JosephPalacios-so/CANSAT_ARLISS/ARLISS_STM32_2026.kicad_pcb

## KiCad design ARLISS_STM32_2026.kicad_pcb (2026-08-25)

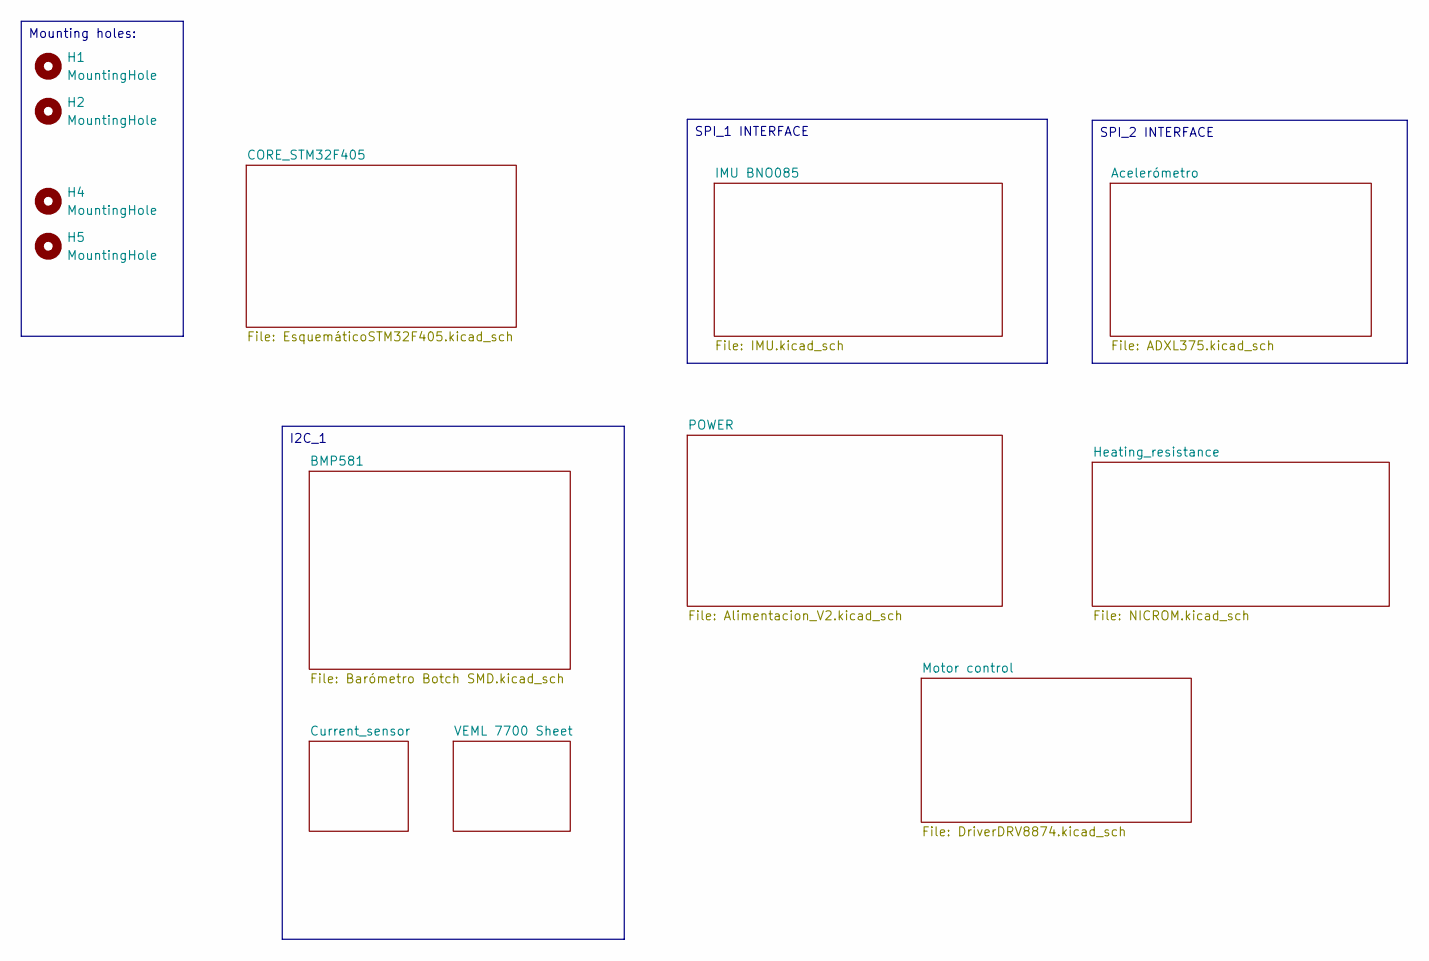
[picture p1: schematic ARLISS_STM32_2026.kicad_sch, ARLISS STM32 BOARD]

Parts:
H1, H2, H4, H5: MountingHole; MountingHole_3.2mm_M3_ISO14580_Pad

Notes on the sheet:
SPI_1 INTERFACE
Mounting holes:
SPI_2 INTERFACE
I2C_1

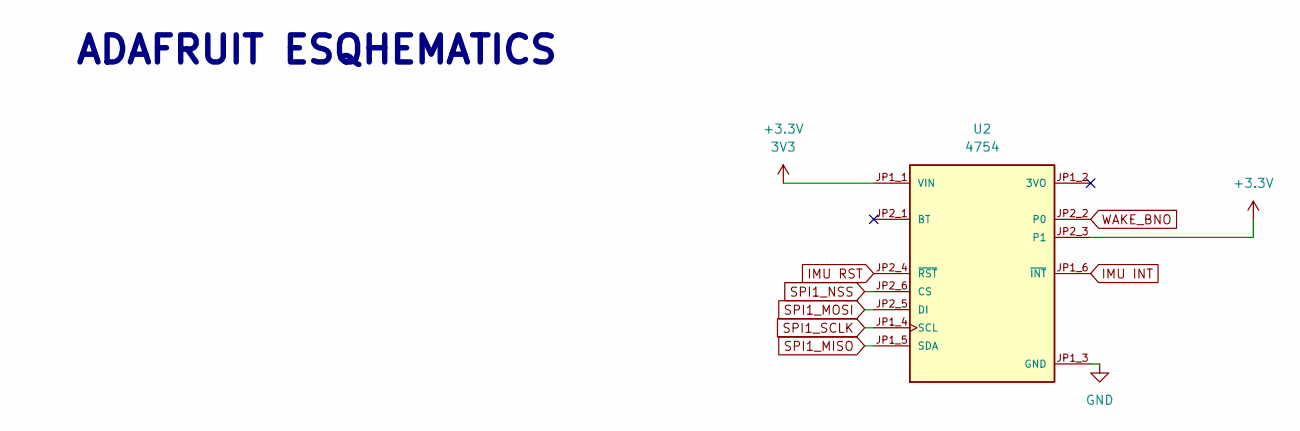
[picture p2: schematic IMU.kicad_sch]

Parts:
U2: 4754; MODULE_4754; PARTREV 2021-03-16

Connections:
+3.3V: U2.JP1_1 (VIN), U2.JP2_3 (P1); also elsewhere on the board
GND: U2.JP1_3 (GND); also elsewhere on the board
IMU INT: U2.JP1_6 (~INT); also elsewhere on the board
IMU RST: U2.JP2_4 (~RST); also elsewhere on the board
SPI1_MISO: U2.JP1_5 (SDA); also elsewhere on the board
SPI1_MOSI: U2.JP2_5 (DI); also elsewhere on the board
SPI1_NSS: U2.JP2_6 (CS); also elsewhere on the board
SPI1_SCLK: U2.JP1_4 (SCL); also elsewhere on the board
WAKE_BNO: U2.JP2_2 (P0); also elsewhere on the board

Notes on the sheet:
ADAFRUIT ESQHEMATICS

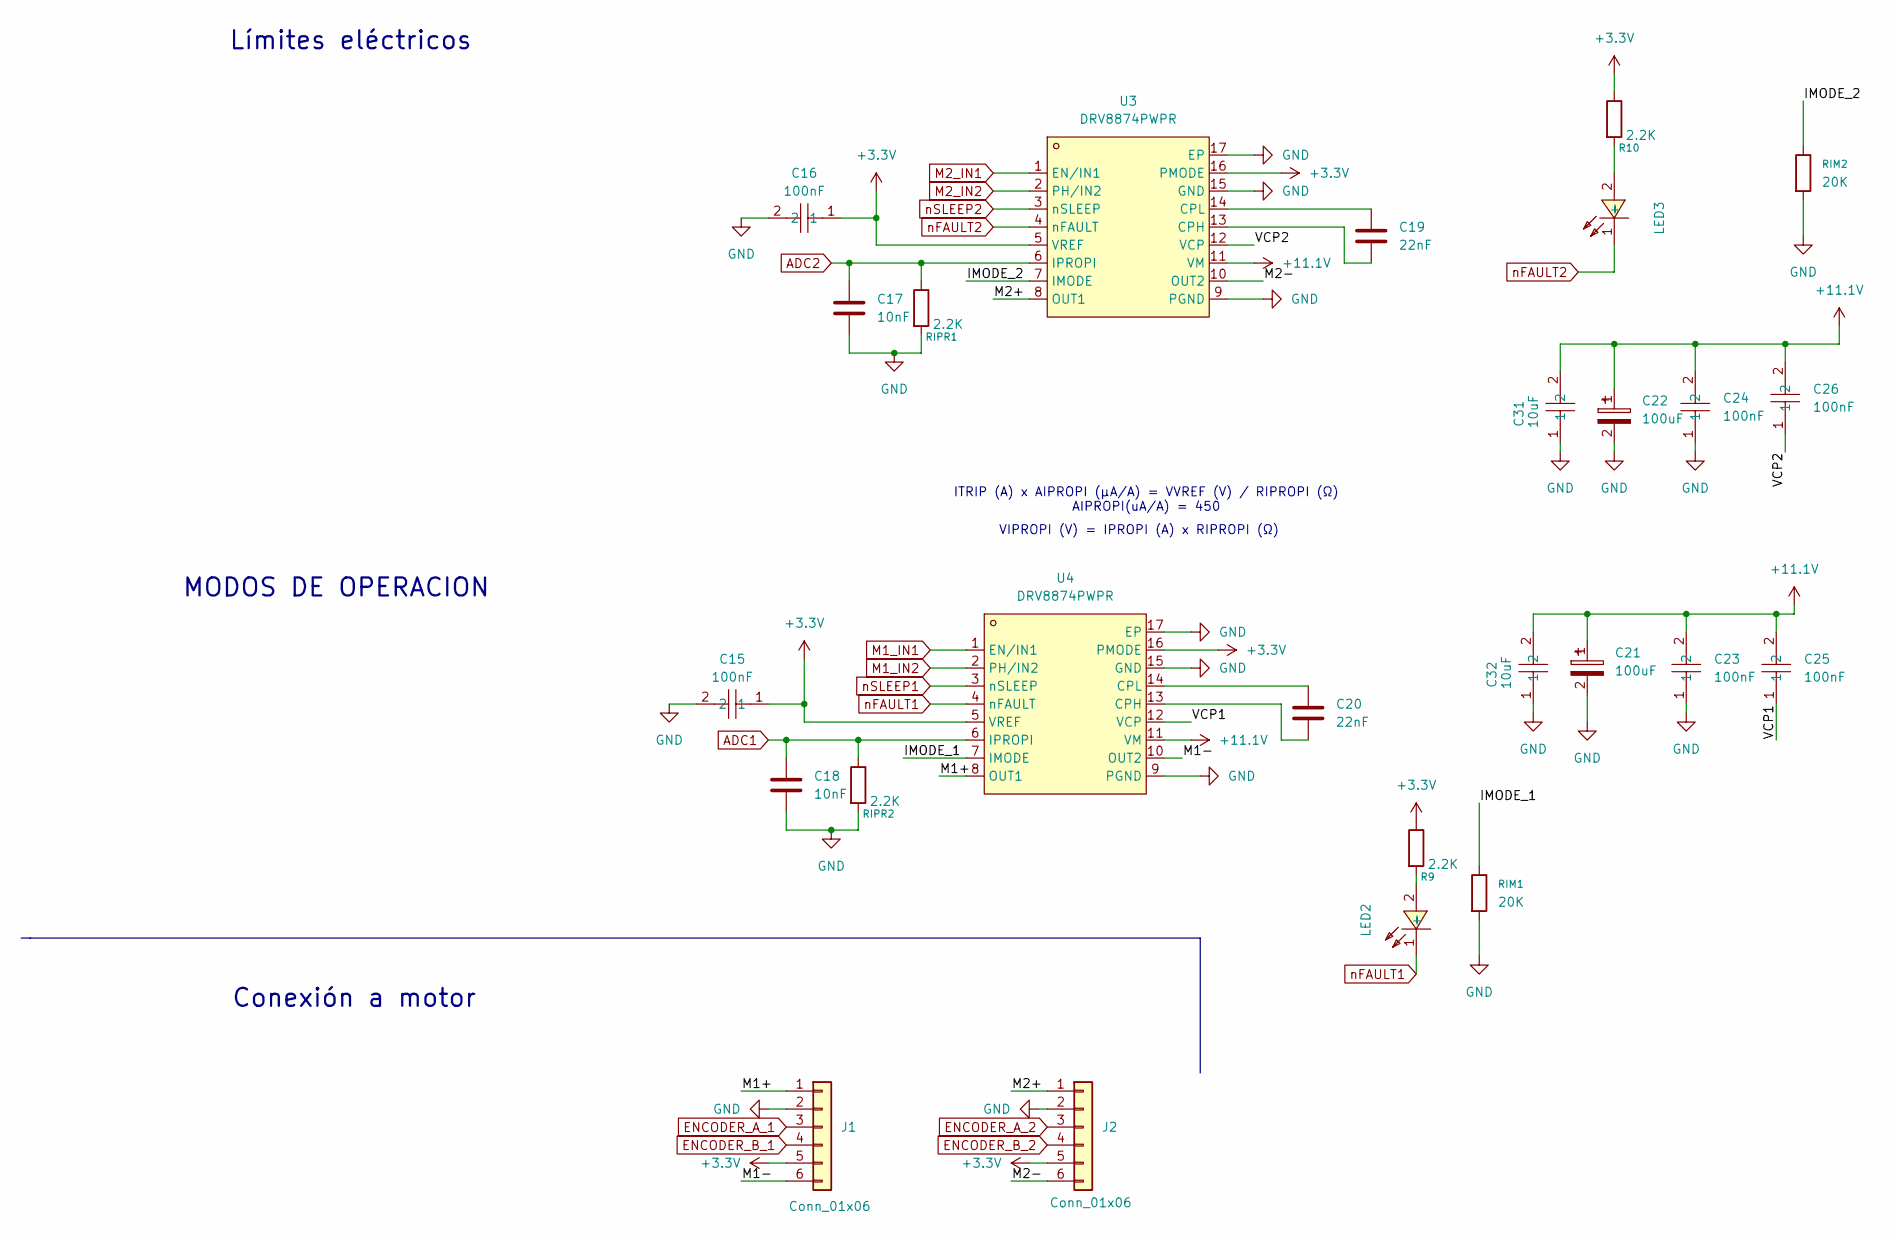
[picture p3: schematic DriverDRV8874.kicad_sch]

Parts:
C15, C16, C23, C24, C25, C26: 100nF; C_0603_1608Metric_Pad1.08x0.95mm_HandSolder; MPN TCC0402X7R104J500AT; LCSC Part C282518
C17, C18: 10nF; C_0603_1608Metric_Pad1.08x0.95mm_HandSolder; LCSC C85973
C19, C20: 22nF; C_0603_1608Metric_Pad1.08x0.95mm_HandSolder; LCSC C541460
C21, C22: 100uF; CAP-SMD_BD6.3-L6.6-W6.6-FD; MPN UCM1H101MCL1GS; LCSC Part C729685
C31, C32: 10uF; C_0805_2012Metric_Pad1.18x1.45mm_HandSolder; MPN CL21B106KAYQNNE; LCSC Part C3039694
J1: Conn_01x06; JST_XH_B6B-XH-A_1x06_P2.50mm_Vertical; LCSC C144397
J2: Conn_01x06; JST_XH_B6B-XH-A_1x06_P2.50mm_Vertical
LED2, LED3: D-R060306L3-KS2; D_0603_1608Metric_Pad1.05x0.95mm_HandSolder; MPN D-060306R1/SS2/L; LCSC Part C118330
R9, R10: 2.2K; R_0603_1608Metric_Pad0.98x0.95mm_HandSolder; LCSC C125931
RIM1, RIM2: 20K; R_0603_1608Metric_Pad0.98x0.95mm_HandSolder; LCSC C7274188
RIPR1, RIPR2: 2.2K; R_0603_1608Metric_Pad0.98x0.95mm_HandSolder; LCSC C125931
U3, U4: DRV8874PWPR; HTSSOP-16_L5.0-W4.4-P0.65-LS6.4-BL-EP; MPN DRV8874PWPR; LCSC Part C1855818

Connections:
+3.3V: C15.1, C16.1, J1.5, J2.5, R9.1, R10.1, U3.5 (VREF), U3.16 (PMODE), U4.5 (VREF), U4.16 (PMODE); also elsewhere on the board
+11.1V: C21.1, C22.1, C23.2, C24.2, C25.2, C26.2, C31.2, C32.2, U3.11 (VM), U4.11 (VM); also elsewhere on the board
/Motor control/IMODE_1: RIM1.1, U4.7 (IMODE)
/Motor control/IMODE_2: RIM2.1, U3.7 (IMODE)
/Motor control/M1+: J1.1, U4.8 (OUT1)
/Motor control/M1-: J1.6, U4.10 (OUT2)
/Motor control/M2+: J2.1, U3.8 (OUT1)
/Motor control/M2-: J2.6, U3.10 (OUT2)
/Motor control/VCP1: C25.1, U4.12 (VCP)
/Motor control/VCP2: C26.1, U3.12 (VCP)
ADC1: C18.1, RIPR2.1, U4.6 (IPROPI); also elsewhere on the board
ADC2: C17.1, RIPR1.1, U3.6 (IPROPI); also elsewhere on the board
ENCODER_A_1: J1.3; also elsewhere on the board
ENCODER_A_2: J2.3; also elsewhere on the board
ENCODER_B_1: J1.4; also elsewhere on the board
ENCODER_B_2: J2.4; also elsewhere on the board
GND: C15.2, C16.2, C17.2, C18.2, C21.2, C22.2, C23.1, C24.1, C31.1, C32.1, J1.2, J2.2, RIM1.2, RIM2.2, RIPR1.2, RIPR2.2, U3.9 (PGND), U3.15 (GND), U3.17 (EP), U4.9 (PGND), U4.15 (GND), U4.17 (EP); also elsewhere on the board
M1_IN1: U4.1 (EN/IN1); also elsewhere on the board
M1_IN2: U4.2 (PH/IN2); also elsewhere on the board
M2_IN1: U3.1 (EN/IN1); also elsewhere on the board
M2_IN2: U3.2 (PH/IN2); also elsewhere on the board
unnamed: LED2.2 (+), R9.2
unnamed: LED3.2 (+), R10.2
unnamed: C19.2, U3.13 (CPH)
unnamed: C19.1, U3.14 (CPL)
unnamed: C20.2, U4.13 (CPH)
unnamed: C20.1, U4.14 (CPL)
nFAULT1: LED2.1 (-), U4.4 (nFAULT); also elsewhere on the board
nFAULT2: LED3.1 (-), U3.4 (nFAULT); also elsewhere on the board
nSLEEP1: U4.3 (nSLEEP); also elsewhere on the board
nSLEEP2: U3.3 (nSLEEP); also elsewhere on the board

Notes on the sheet:
Límites eléctricos
MODOS DE OPERACION
VIPROPI (V) = IPROPI (A) x RIPROPI (Ω)
Conexión a motor
ITRIP (A) x AIPROPI (μA/A) = VVREF (V) / RIPROPI (Ω) AIPROPI(uA/A) = 450

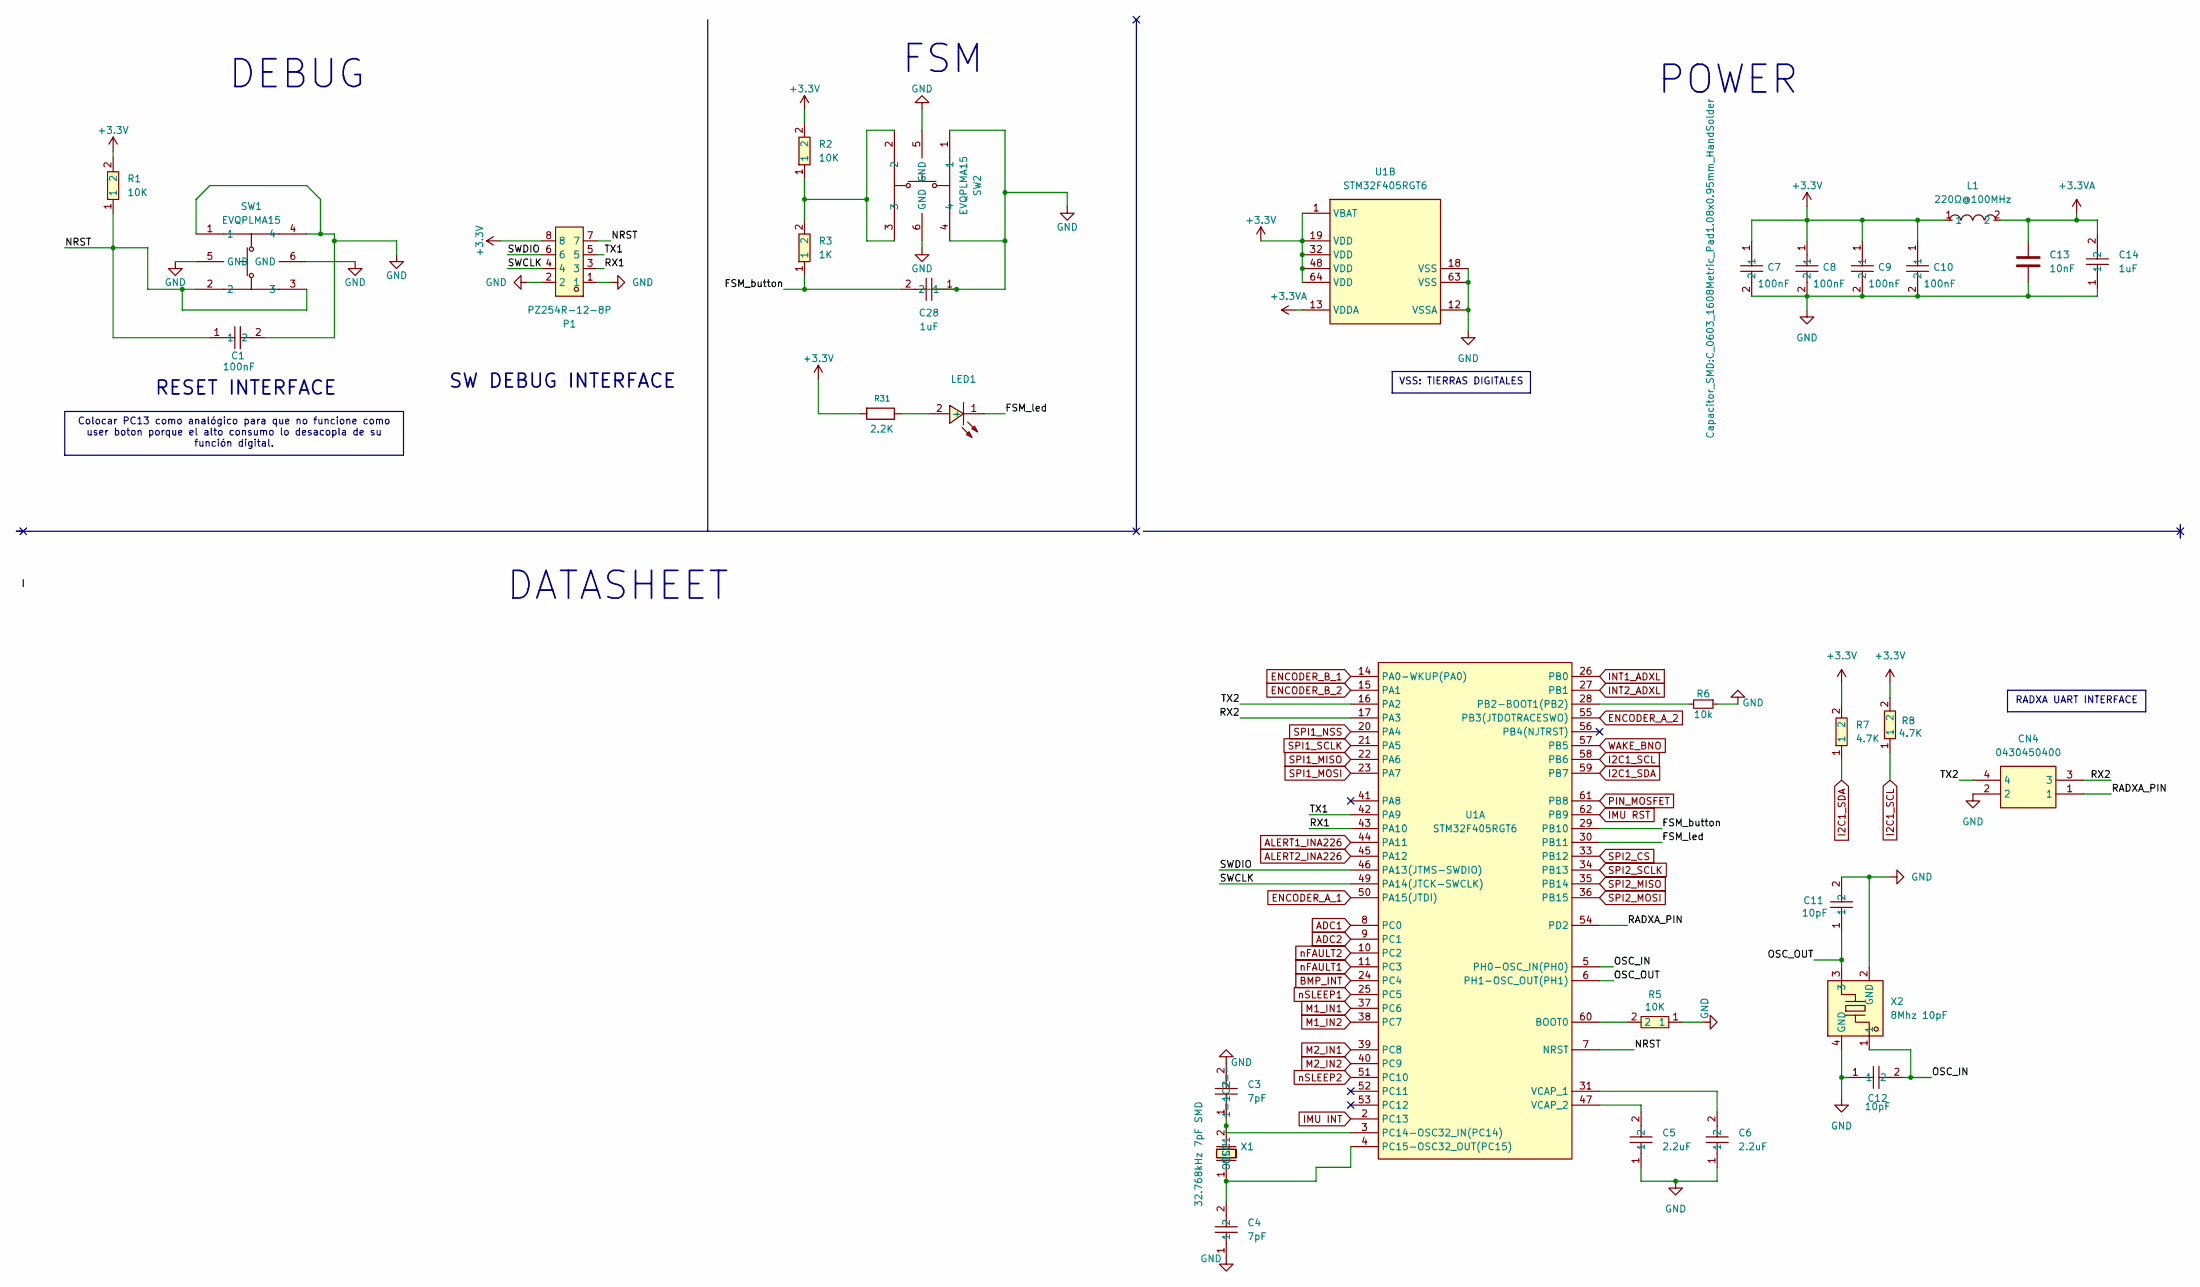
[picture p4: schematic EsquemáticoSTM32F405.kicad_sch]

Parts:
C1, C7, C8, C9, C10: 100nF; C_0603_1608Metric_Pad1.08x0.95mm_HandSolder; MPN TCC0402X7R104J500AT; LCSC Part C282518
C3, C4: 7pF; C_0603_1608Metric_Pad1.08x0.95mm_HandSolder; MPN CC0402CRNPO9BN7R0; LCSC Part C519115
C5, C6: 2.2uF; C_0603_1608Metric_Pad1.08x0.95mm_HandSolder; MPN GRM155Z71A225KE44D; LCSC Part C86018
C11, C12: 10pF; C_0603_1608Metric_Pad1.08x0.95mm_HandSolder; MPN CC0402FRNPO9BN100; LCSC Part C309467
C13: 10nF; C_0603_1608Metric_Pad1.08x0.95mm_HandSolder; LCSC C85973
C14, C28: 1uF; C_0603_1608Metric_Pad1.08x0.95mm_HandSolder; MPN CGA0402X5R105K500GT; LCSC Part C559769
CN4: 0430450400; CONN-TH_0430450400; MPN 0430450400; LCSC Part C122413
L1: 220Ω@100MHz; L_0603_1608Metric_Pad1.05x0.95mm_HandSolder; MPN MPZ1608S221ATA00; LCSC Part C76815
LED1: D-R060306L3-KS2; D_0603_1608Metric_Pad1.05x0.95mm_HandSolder; MPN D-060306R1/SS2/L; LCSC Part C118330
P1: PZ254R-12-8P; HDR-TH_8P-P2.54-H-M-R2-C4-S2.54; MPN PZ254R-12-8P; LCSC Part C492432
R1, R2, R5: 10K; R_0603_1608Metric_Pad0.98x0.95mm_HandSolder; MPN RC0603FR-7W10KL; LCSC Part C859110
R3: 1K; R_0603_1608Metric_Pad0.98x0.95mm_HandSolder; MPN RC0603FR-071KL; LCSC Part C22548
R6: 10k; R_0603_1608Metric_Pad0.98x0.95mm_HandSolder; LCSC Part # C25744
R7, R8: 4.7K; R_0603_1608Metric_Pad0.98x0.95mm_HandSolder; MPN RC0603FR-074K7L; LCSC Part C99782
R31: 2.2K; R_0603_1608Metric_Pad0.98x0.95mm_HandSolder; LCSC C114611
SW1, SW2: EVQPLMA15; KEY-SMD_6P-L4.9-4.9-P3.70; MPN EVQPLMA15; LCSC Part C128538
U1: STM32F405RGT6; LQFP-64_L10.0-W10.0-P0.50-LS12.0-BL; MPN STM32F405RGT6; LCSC Part C15742
X1: 32.768kHz 7pF SMD; Crystal_SMD_2012-2Pin_2.0x1.2mm_HandSoldering; MPN X1A0000610006; LCSC Part C99009
X2: 8Mhz 10pF; CRYSTAL-SMD_4P-L3.2-W2.5-BL; MPN XTM32008000GT00351001; LCSC Part C42464264

Connections:
+3.3V: C7.1, C8.1, C9.1, C10.1, L1.1, P1.8, R1.2, R2.2, R7.2, R8.2, R31.2, U1.1 (VBAT), U1.19 (VDD), U1.32 (VDD), U1.48 (VDD), U1.64 (VDD); also elsewhere on the board
+3.3VA: C13.1, C14.2, L1.2, U1.13 (VDDA)
/CORE_STM32F405/FSM_button: C28.2, R3.1, U1.29 (PB10)
/CORE_STM32F405/FSM_led: LED1.1 (-), U1.30 (PB11)
/CORE_STM32F405/NRST: C1.1, P1.7, R1.1, SW1.2, SW1.3, U1.7 (NRST)
/CORE_STM32F405/OSC_IN: C12.2, U1.5 (PH0-OSC_IN(PH0)), X2.1
/CORE_STM32F405/OSC_OUT: C11.1, U1.6 (PH1-OSC_OUT(PH1)), X2.3
/CORE_STM32F405/RADXA_PIN: CN4.1, U1.54 (PD2)
/CORE_STM32F405/RX1: P1.3, U1.43 (PA10)
/CORE_STM32F405/RX2: CN4.3, U1.17 (PA3)
/CORE_STM32F405/SWCLK: P1.4, U1.49 (PA14(JTCK-SWCLK))
/CORE_STM32F405/SWDIO: P1.6, U1.46 (PA13(JTMS-SWDIO))
/CORE_STM32F405/TX1: P1.5, U1.42 (PA9)
/CORE_STM32F405/TX2: CN4.4, U1.16 (PA2)
ADC1: U1.8 (PC0); also elsewhere on the board
ADC2: U1.9 (PC1); also elsewhere on the board
ALERT1_INA226: U1.44 (PA11); also elsewhere on the board
ALERT2_INA226: U1.45 (PA12); also elsewhere on the board
BMP_INT: U1.24 (PC4); also elsewhere on the board
ENCODER_A_1: U1.50 (PA15(JTDI)); also elsewhere on the board
ENCODER_A_2: U1.55 (PB3(JTDOTRACESWO)); also elsewhere on the board
ENCODER_B_1: U1.14 (PA0-WKUP(PA0)); also elsewhere on the board
ENCODER_B_2: U1.15 (PA1); also elsewhere on the board
GND: C1.2, C3.2, C4.1, C5.1, C6.1, C7.2, C8.2, C9.2, C10.2, C11.2, C12.1, C13.2, C14.1, C28.1, CN4.2, P1.1, P1.2, R5.1, R6.1, SW1.1, SW1.4, SW1.5 (GND), SW1.6 (GND), SW2.1, SW2.4, SW2.5 (GND), SW2.6 (GND), U1.12 (VSSA), U1.18 (VSS), U1.63 (VSS), X2.2 (GND), X2.4 (GND); also elsewhere on the board
I2C1_SCL: R8.1, U1.58 (PB6); also elsewhere on the board
I2C1_SDA: R7.1, U1.59 (PB7); also elsewhere on the board
IMU INT: U1.2 (PC13); also elsewhere on the board
IMU RST: U1.62 (PB9); also elsewhere on the board
INT1_ADXL: U1.26 (PB0); also elsewhere on the board
INT2_ADXL: U1.27 (PB1); also elsewhere on the board
M1_IN1: U1.37 (PC6); also elsewhere on the board
M1_IN2: U1.38 (PC7); also elsewhere on the board
M2_IN1: U1.39 (PC8); also elsewhere on the board
M2_IN2: U1.40 (PC9); also elsewhere on the board
unnamed: LED1.2 (+), R31.1
unnamed: R2.1, R3.2, SW2.2, SW2.3
unnamed: R5.2, U1.60 (BOOT0)
unnamed: R6.2, U1.28 (PB2-BOOT1(PB2))
unnamed: C3.1, U1.3 (PC14-OSC32_IN(PC14)), X1.2 (OSC2)
unnamed: C4.2, U1.4 (PC15-OSC32_OUT(PC15)), X1.1 (OSC1)
unnamed: C6.2, U1.31 (VCAP_1)
unnamed: C5.2, U1.47 (VCAP_2)
PIN_MOSFET: U1.61 (PB8); also elsewhere on the board
SPI1_MISO: U1.22 (PA6); also elsewhere on the board
SPI1_MOSI: U1.23 (PA7); also elsewhere on the board
SPI1_NSS: U1.20 (PA4); also elsewhere on the board
SPI1_SCLK: U1.21 (PA5); also elsewhere on the board
SPI2_CS: U1.33 (PB12); also elsewhere on the board
SPI2_MISO: U1.35 (PB14); also elsewhere on the board
SPI2_MOSI: U1.36 (PB15); also elsewhere on the board
SPI2_SCLK: U1.34 (PB13); also elsewhere on the board
WAKE_BNO: U1.57 (PB5); also elsewhere on the board
nFAULT1: U1.11 (PC3); also elsewhere on the board
nFAULT2: U1.10 (PC2); also elsewhere on the board
nSLEEP1: U1.25 (PC5); also elsewhere on the board
nSLEEP2: U1.51 (PC10); also elsewhere on the board

Notes on the sheet:
RESET INTERFACE
DATASHEET
DEBUG
SW DEBUG INTERFACE
POWER
FSM
Colocar PC13 como analógico para que no funcione como user boton porque el alto consumo lo desacopla de su función digital.
RADXA UART INTERFACE
VSS: TIERRAS DIGITALES

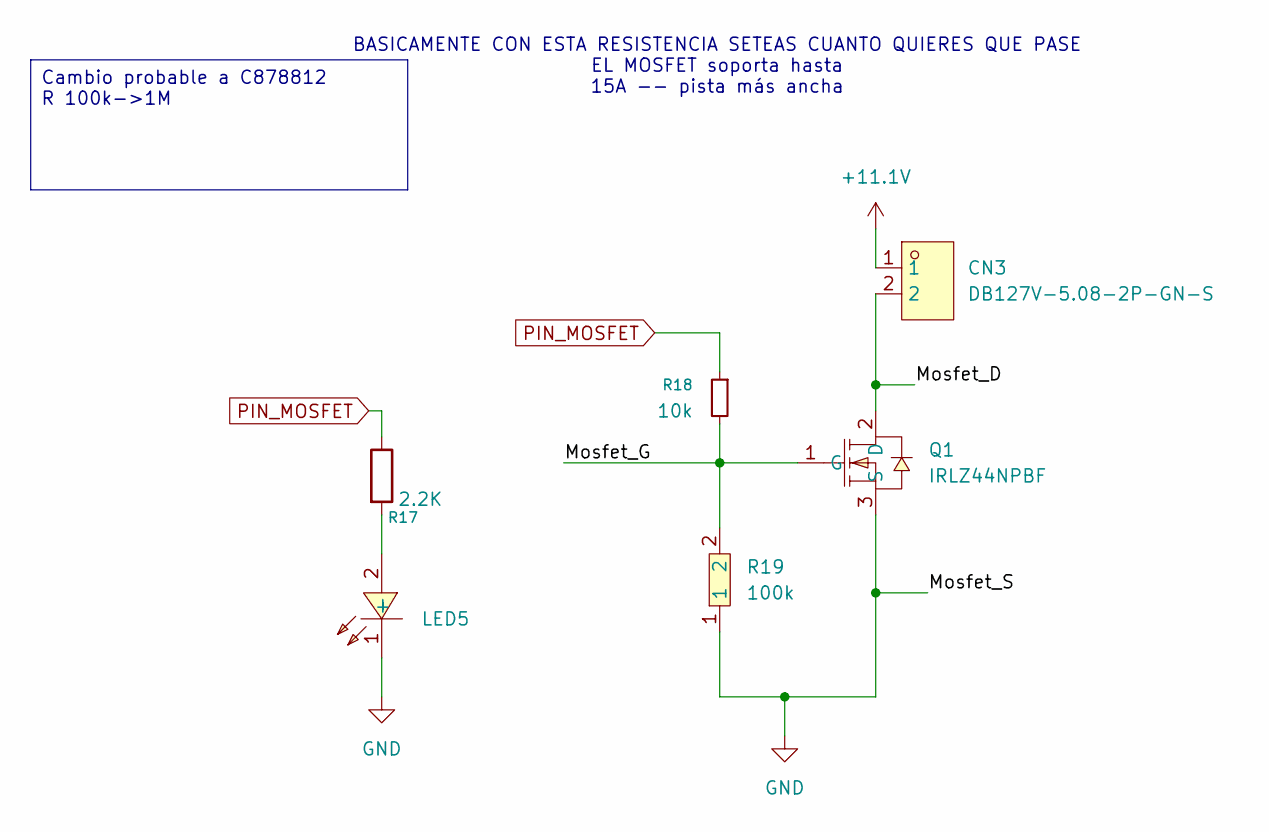
[picture p5: schematic NICROM.kicad_sch]

Parts:
CN3: DB127V-5.08-2P-GN-S; CONN-TH_2P-P5.08; MPN DB127V-5.08-2P-GN-S; LCSC Part C3018698
LED5: D-R060306L3-KS2; D_0603_1608Metric_Pad1.05x0.95mm_HandSolder; MPN D-060306R1/SS2/L; LCSC Part C118330
Q1: IRLZ44NPBF; TO-220-3_Horizontal_TabDown; MPN IRLZ44NPBF; LCSC Part C38774
R17: 2.2K; R_0603_1608Metric_Pad0.98x0.95mm_HandSolder; LCSC C114611
R18: 10k; R_0603_1608Metric_Pad0.98x0.95mm_HandSolder
R19: 100k; R_0603_1608Metric_Pad0.98x0.95mm_HandSolder; MPN RC0603FR-07100KL; LCSC Part C14675

Connections:
+11.1V: CN3.1; also elsewhere on the board
/Heating_resistance/Mosfet_D: CN3.2, Q1.2 (D)
/Heating_resistance/Mosfet_G: Q1.1 (G), R18.2, R19.2
GND: LED5.1 (-), Q1.3 (S), R19.1; also elsewhere on the board
unnamed: LED5.2 (+), R17.2
PIN_MOSFET: R17.1, R18.1; also elsewhere on the board

Notes on the sheet:
BASICAMENTE CON ESTA RESISTENCIA SETEAS CUANTO QUIERES QUE PASE EL MOSFET soporta hasta 15A -- pista más ancha
Cambio probable a C878812 R 100k->1M

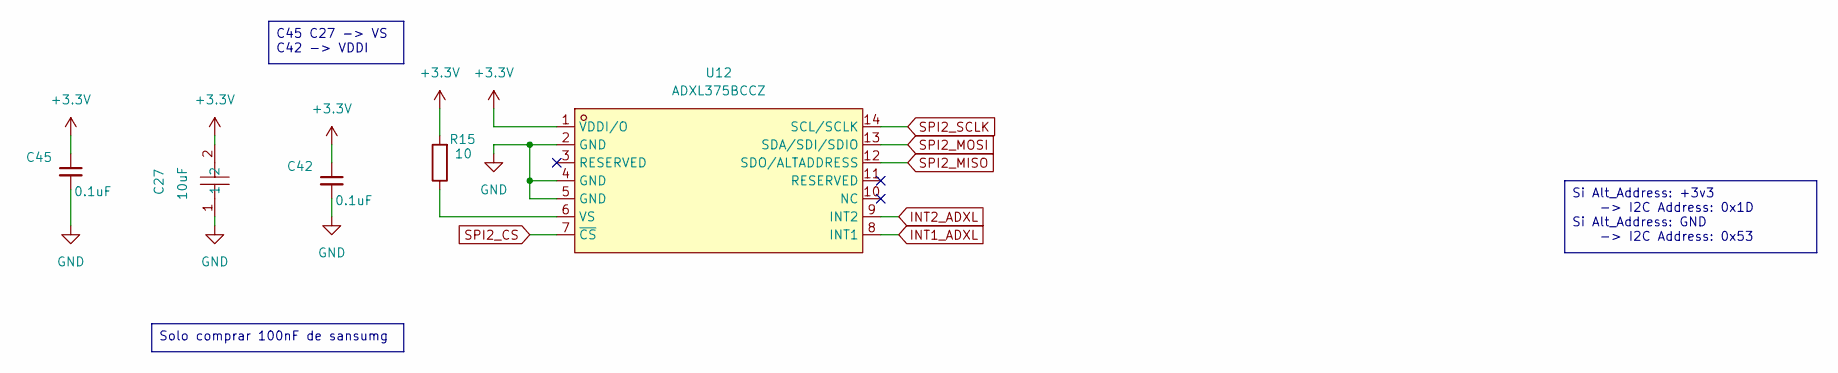
[picture p6: schematic ADXL375.kicad_sch]

Parts:
C27: 10uF; C_0805_2012Metric_Pad1.18x1.45mm_HandSolder; MPN CL21B106KAYQNNE; LCSC Part C3039694
C42: 0.1uF; C_0603_1608Metric_Pad1.08x0.95mm_HandSolder
C45: 0.1uF; C_0603_1608Metric
R15: 10; R_0603_1608Metric_Pad0.98x0.95mm_HandSolder
U12: ADXL375BCCZ; LGA-14_L5.0-W3.0-P0.80-BL; LCSC Part C579466

Connections:
+3.3V: C27.2, C42.1, C45.1, R15.2, U12.1 (VDDI/O); also elsewhere on the board
GND: C27.1, C42.2, C45.2, U12.2 (GND), U12.4 (GND), U12.5 (GND); also elsewhere on the board
INT1_ADXL: U12.8 (INT1); also elsewhere on the board
INT2_ADXL: U12.9 (INT2); also elsewhere on the board
unnamed: R15.1, U12.6 (VS)
SPI2_CS: U12.7 (~CS); also elsewhere on the board
SPI2_MISO: U12.12 (SDO/ALTADDRESS); also elsewhere on the board
SPI2_MOSI: U12.13 (SDA/SDI/SDIO); also elsewhere on the board
SPI2_SCLK: U12.14 (SCL/SCLK); also elsewhere on the board

Notes on the sheet:
Solo comprar 100nF de sansumg
Si Alt_Address: +3v3 -> I2C Address: 0x1D Si Alt_Address: GND -> I2C Address: 0x53
C45 C27 -> VS C42 -> VDDI

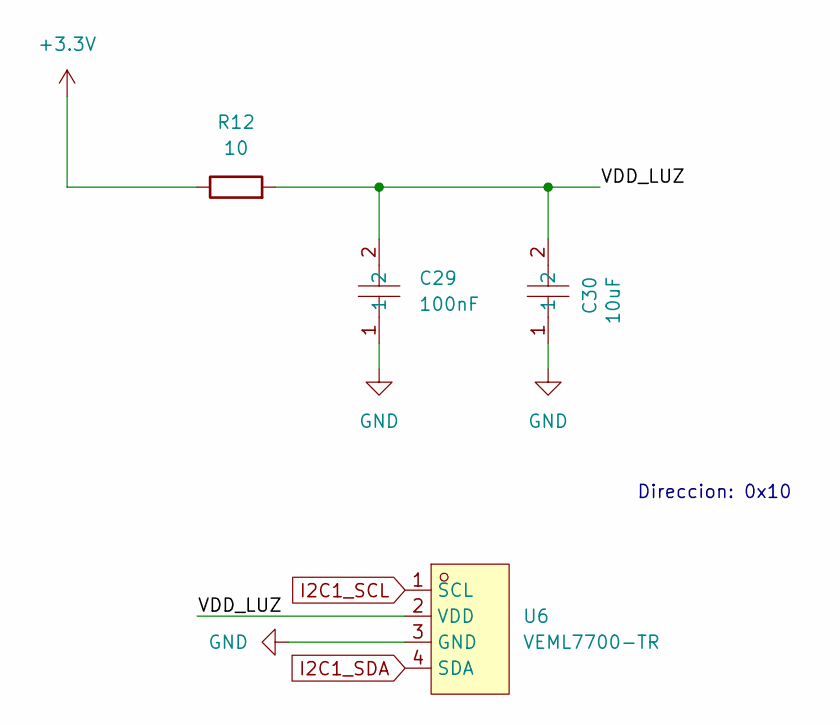
[picture p7: schematic SensorLuz_VEML7700.kicad_sch]

Parts:
C29: 100nF; C_0603_1608Metric_Pad1.08x0.95mm_HandSolder; MPN TCC0402X7R104J500AT; LCSC Part C282518
C30: 10uF; C_0805_2012Metric_Pad1.18x1.45mm_HandSolder; MPN CL21B106KAYQNNE; LCSC Part C3039694
R12: 10; R_0603_1608Metric_Pad0.98x0.95mm_HandSolder
U6: VEML7700-TR; LED-SMD_4P-L6.8-W2.4_VEML7700-TR; MPN VEML7700-TR; LCSC Part C504893

Connections:
+3.3V: R12.1; also elsewhere on the board
/VEML 7700 Sheet/VDD_LUZ: C29.2, C30.2, R12.2, U6.2 (VDD)
GND: C29.1, C30.1, U6.3 (GND); also elsewhere on the board
I2C1_SCL: U6.1 (SCL); also elsewhere on the board
I2C1_SDA: U6.4 (SDA); also elsewhere on the board

Notes on the sheet:
Direccion: 0x10

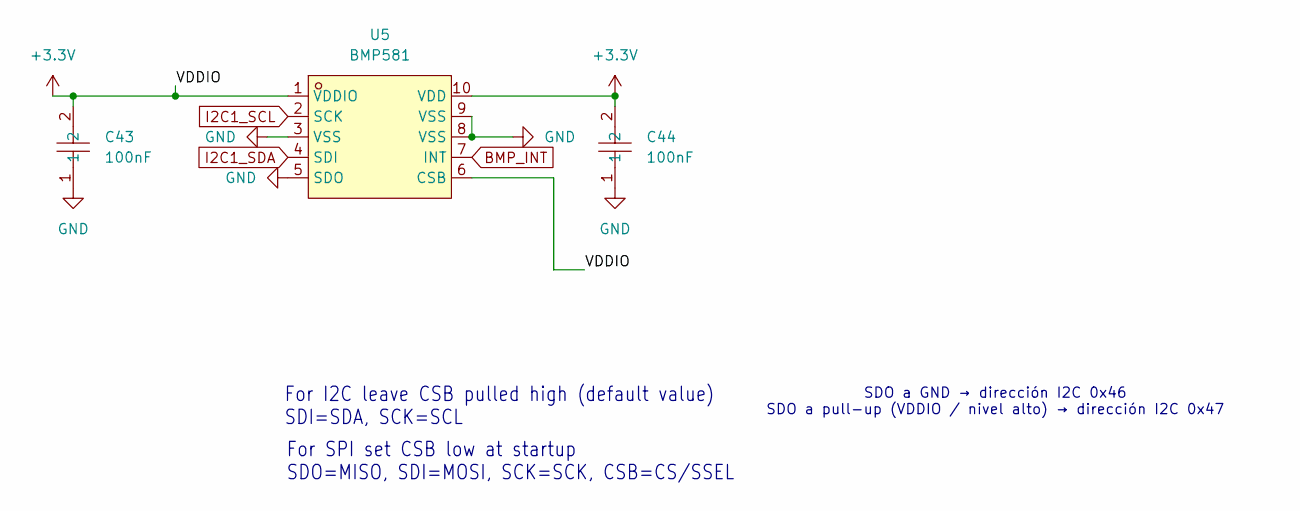
[picture p8: schematic Barómetro Botch SMD.kicad_sch]

Parts:
C43, C44: 100nF; C_0603_1608Metric_Pad1.08x0.95mm_HandSolder; MPN TCC0402X7R104J500AT; LCSC Part C282518
U5: BMP581; LGA-10_L2.0-W2.0-P0.50-TL_BMP581; MPN BMP581; LCSC Part C5362283

Connections:
+3.3V: C43.2, C44.2, U5.1 (VDDIO), U5.6 (CSB), U5.10 (VDD); also elsewhere on the board
BMP_INT: U5.7 (INT); also elsewhere on the board
GND: C43.1, C44.1, U5.3 (VSS), U5.5 (SDO), U5.8 (VSS), U5.9 (VSS); also elsewhere on the board
I2C1_SCL: U5.2 (SCK); also elsewhere on the board
I2C1_SDA: U5.4 (SDI); also elsewhere on the board

Notes on the sheet:
For I2C leave CSB pulled high (default value) SDI=SDA, SCK=SCL
For SPI set CSB low at startup SDO=MISO, SDI=MOSI, SCK=SCK, CSB=CS/SSEL
SDO a GND → dirección I2C 0x46 SDO a pull-up (VDDIO / nivel alto) → dirección I2C 0x47

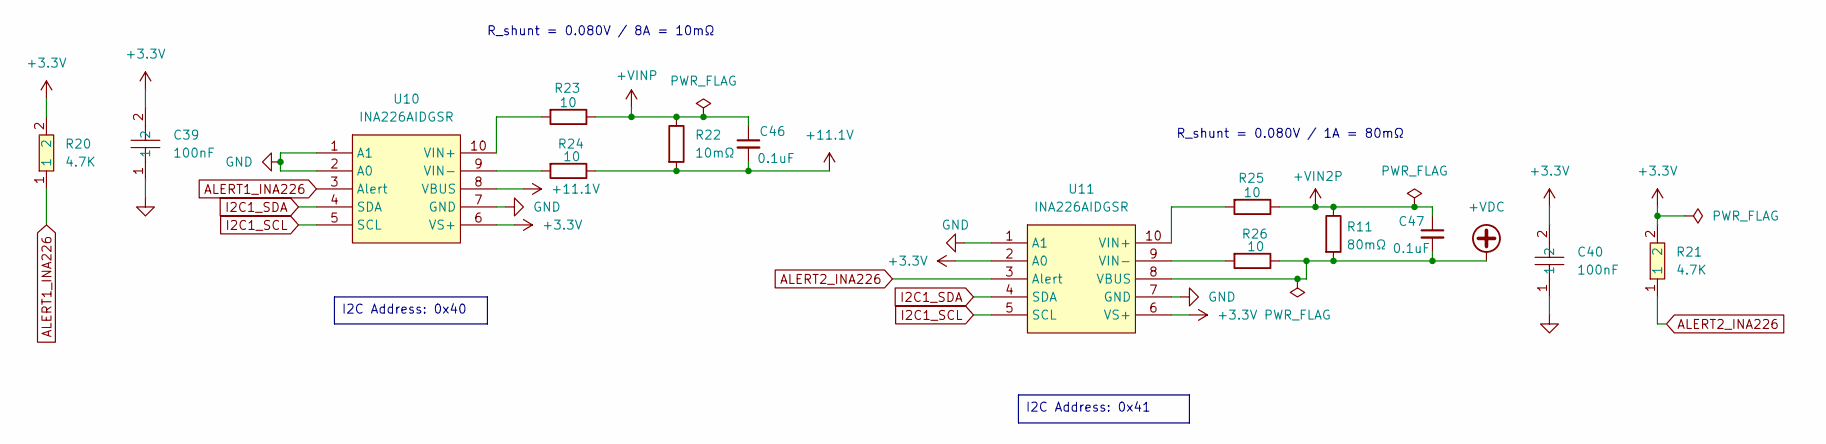
[picture p9: schematic INA226_sensor_sch.kicad_sch]

Parts:
C39, C40: 100nF; C_0603_1608Metric_Pad1.08x0.95mm_HandSolder; MPN TCC0402X7R104J500AT; LCSC Part C282518
C46, C47: 0.1uF; C_0603_1608Metric_Pad1.08x0.95mm_HandSolder
R11: 80mΩ; R_1206_3216Metric_Pad1.30x1.75mm_HandSolder
R20, R21: 4.7K; R_0603_1608Metric_Pad0.98x0.95mm_HandSolder; MPN RC0603FR-074K7L; LCSC Part C99782
R22: 10mΩ; R_2512_6332Metric_Pad1.40x3.35mm_HandSolder
R23, R24, R25, R26: 10; R_0603_1608Metric_Pad0.98x0.95mm_HandSolder
U10, U11: INA226AIDGSR; MSOP-10_L3.0-W3.0-P0.50-LS5.0-BL; MPN INA226AIDGSR; LCSC Part C49851

Connections:
+3.3V: C39.2, C40.2, R20.2, R21.2, U10.6 (VS+), U11.2 (A0), U11.6 (VS+); also elsewhere on the board
+11.1V: C46.2, R22.2, R24.1, U10.8 (VBUS); also elsewhere on the board
+VDC: C47.2, R11.2, R26.1, U11.8 (VBUS); also elsewhere on the board
+VIN2P: C47.1, R11.1, R25.1; also elsewhere on the board
+VINP: C46.1, R22.1, R23.1; also elsewhere on the board
ALERT1_INA226: R20.1, U10.3 (Alert); also elsewhere on the board
ALERT2_INA226: R21.1, U11.3 (Alert); also elsewhere on the board
GND: C39.1, C40.1, U10.1 (A1), U10.2 (A0), U10.7 (GND), U11.1 (A1), U11.7 (GND); also elsewhere on the board
I2C1_SCL: U10.5 (SCL), U11.5 (SCL); also elsewhere on the board
I2C1_SDA: U10.4 (SDA), U11.4 (SDA); also elsewhere on the board
unnamed: R23.2, U10.10 (VIN+)
unnamed: R24.2, U10.9 (VIN-)
unnamed: R25.2, U11.10 (VIN+)
unnamed: R26.2, U11.9 (VIN-)

Notes on the sheet:
R_shunt = 0.080V / 8A = 10mΩ
R_shunt = 0.080V / 1A = 80mΩ
I2C Address: 0x41
I2C Address: 0x40

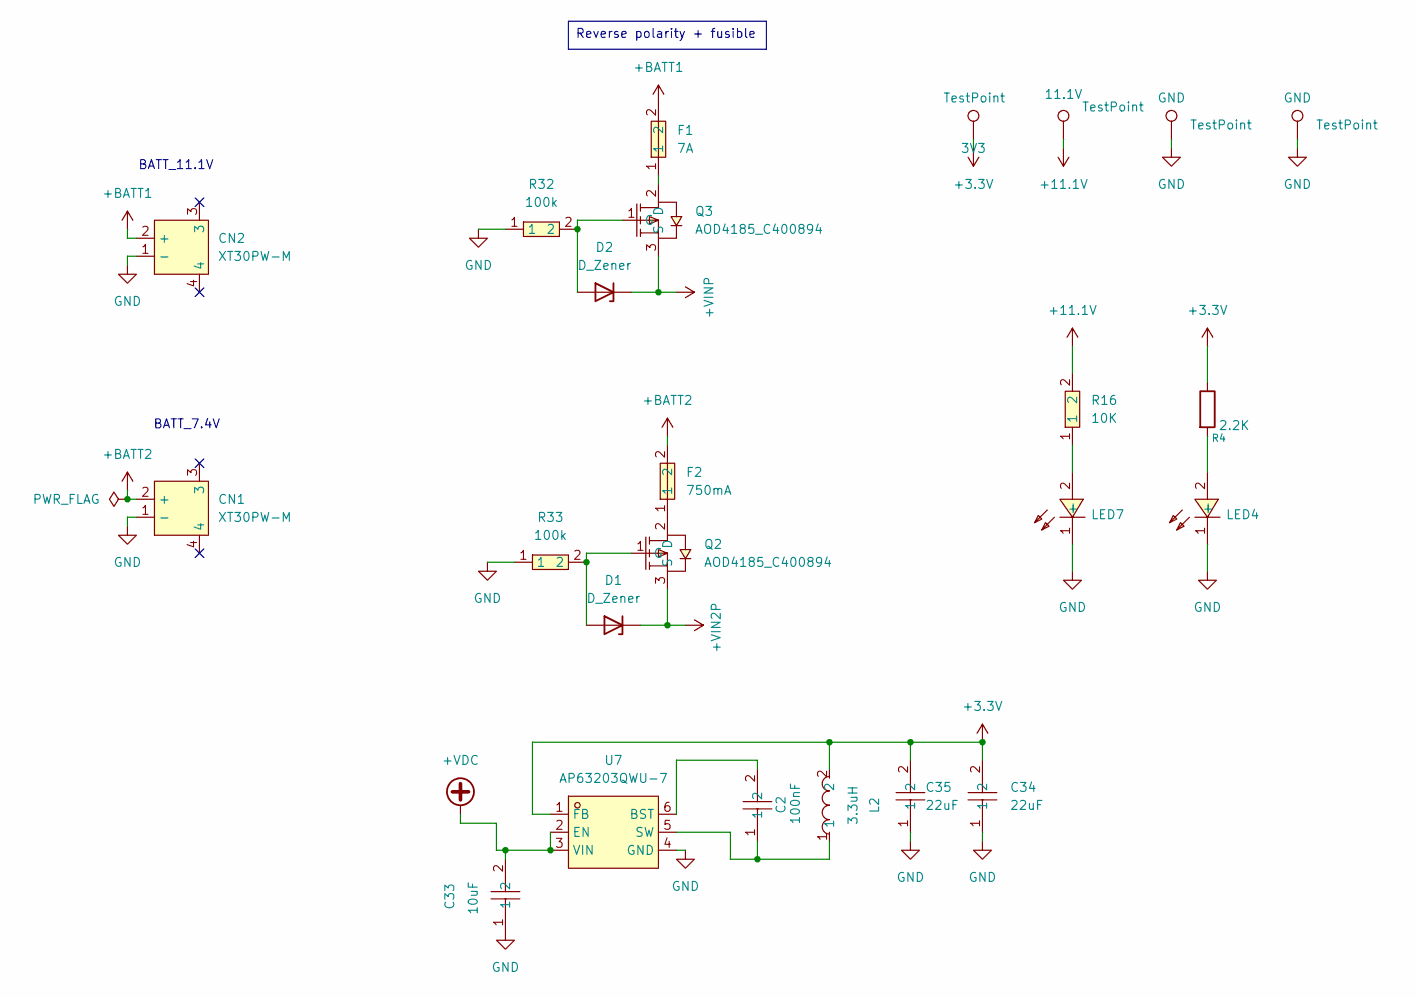
[picture p10: schematic Alimentacion_V2.kicad_sch]

Parts:
C2: 100nF; C_0603_1608Metric_Pad1.08x0.95mm_HandSolder; MPN TCC0402X7R104J500AT; LCSC Part C282518
C33: 10uF; C_0805_2012Metric_Pad1.18x1.45mm_HandSolder; MPN CL21B106KAYQNNE; LCSC Part C3039694
C34, C35: 22uF; C_0805_2012Metric_Pad1.18x1.45mm_HandSolder; MPN C2012X7S1A226MT000E; LCSC Part C342717
CN1, CN2: XT30PW-M; CONN-TH_XT30PW-M; LCSC Part C431092
D1, D2: D_Zener; D_SOD-123
F1: 7A; F1206; MPN LTC1206-1700TS; LCSC Part C52988555
F2: 750mA; F1206; MPN 0466.250NRHF; LCSC Part C83557
L2: 3.3uH; IND-SMD_L4.1-W4.1_FTC404020S; MPN FTC404020S3R3MGCA; LCSC Part C39676071
LED4, LED7: D_0603_1608Metric_Pad1.05x0.95mm_HandSolder; MPN D-060306G1/SS2/G1; LCSC Part C118334
Q2, Q3: AOD4185_C400894; TO-252-3_L6.6-W6.1-P4.57-LS9.9-BR-CW; MPN AOD4185; LCSC Part C400894
R4: 2.2K; R_0603_1608Metric_Pad0.98x0.95mm_HandSolder; LCSC C125931
R16: 10K; R_0603_1608Metric_Pad0.98x0.95mm_HandSolder; MPN RC0603FR-7W10KL; LCSC Part C859110
R32, R33: 100k; R_0603_1608Metric_Pad0.98x0.95mm_HandSolder; MPN RC0603FR-07100KL; LCSC Part C14675
TP1, TP2, TP3, TP4: TestPoint; TestPoint_Pad_D1.5mm
U7: AP63203QWU-7; TSOT-26_L2.9-W1.6-P0.95-LS2.8-BL; MPN AP63203QWU-7; LCSC Part C5248536

Connections:
+3.3V: C34.2, C35.2, L2.2, R4.1, TP1.1 (1_1), U7.1 (FB); also elsewhere on the board
+11.1V: R16.2, TP2.1 (1_1); also elsewhere on the board
+BATT1: CN2.2 (+), F1.2
+BATT2: CN1.2 (+), F2.2
+VDC: C33.2, U7.2 (EN), U7.3 (VIN); also elsewhere on the board
+VIN2P: D1.1 (K), Q2.3 (S); also elsewhere on the board
+VINP: D2.1 (K), Q3.3 (S); also elsewhere on the board
GND: C33.1, C34.1, C35.1, CN1.1 (-), CN2.1 (-), LED4.1 (-), LED7.1 (-), R32.1, R33.1, TP3.1 (1_1), TP4.1 (1_1), U7.4 (GND); also elsewhere on the board
unnamed: D1.2 (A), Q2.1 (G), R33.2
unnamed: D2.2 (A), Q3.1 (G), R32.2
unnamed: LED4.2 (+), R4.2
unnamed: LED7.2 (+), R16.1
unnamed: F2.1, Q2.2 (D)
unnamed: F1.1, Q3.2 (D)
unnamed: C2.2, U7.6 (BST)
unnamed: C2.1, L2.1, U7.5 (SW)

Notes on the sheet:
BATT_11.1V
BATT_7.4V
Reverse polarity + fusible
