JosephPalacios-so/CANSAT_ARLISS/ARLISS_STM32_2026.kicad_pcb

## KiCad design ARLISS_STM32_2026.kicad_pcb (continued)

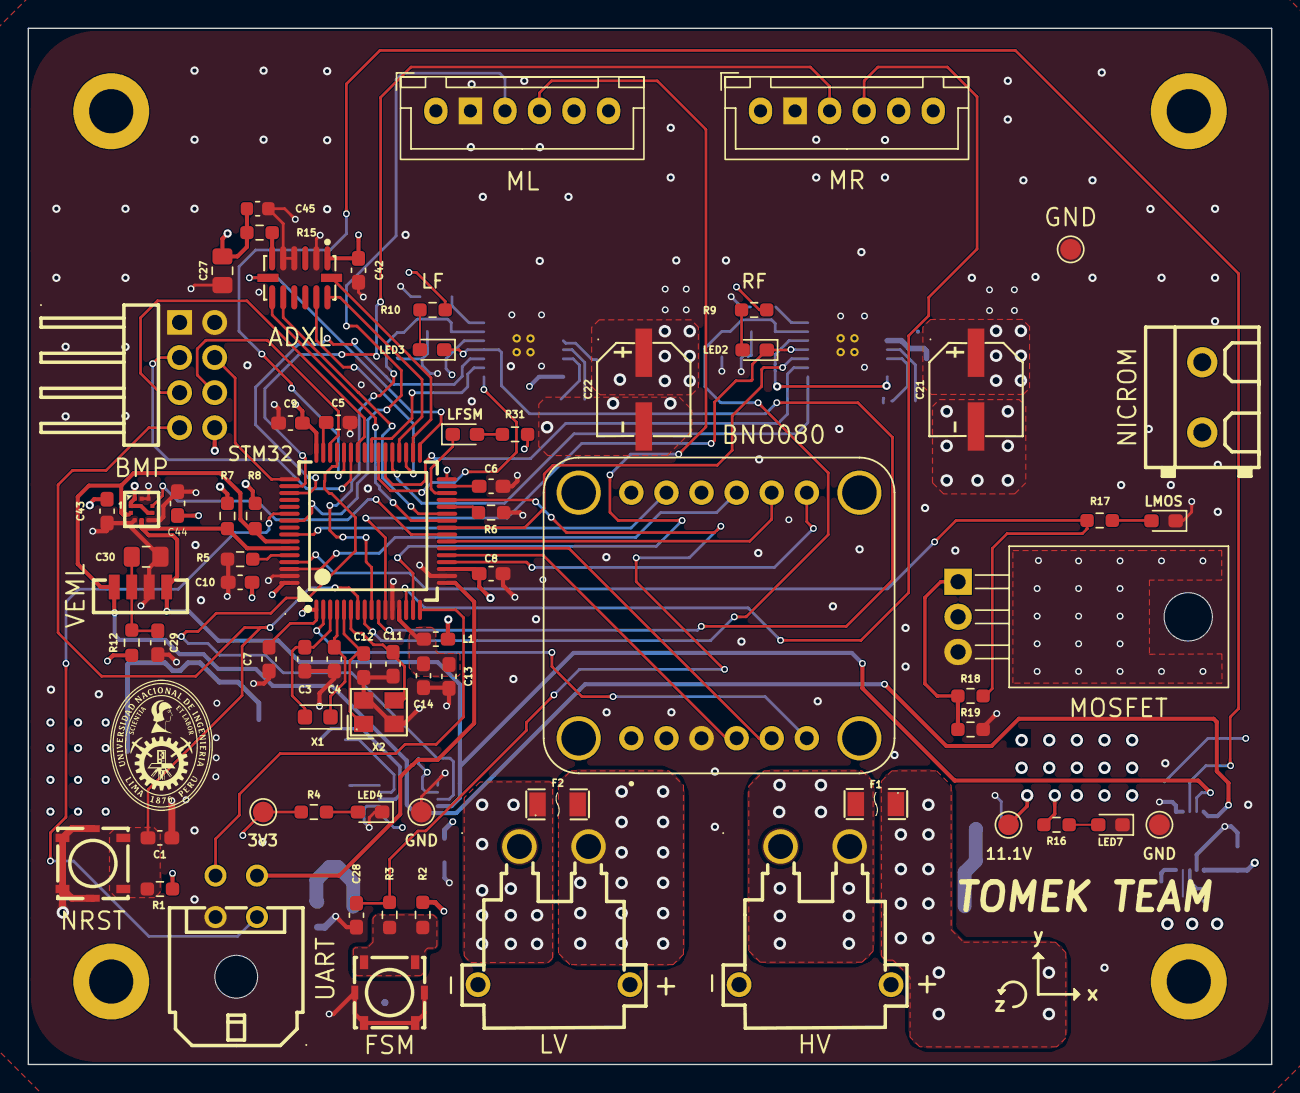
[picture p11: board ARLISS_STM32_2026.kicad_pcb from above]

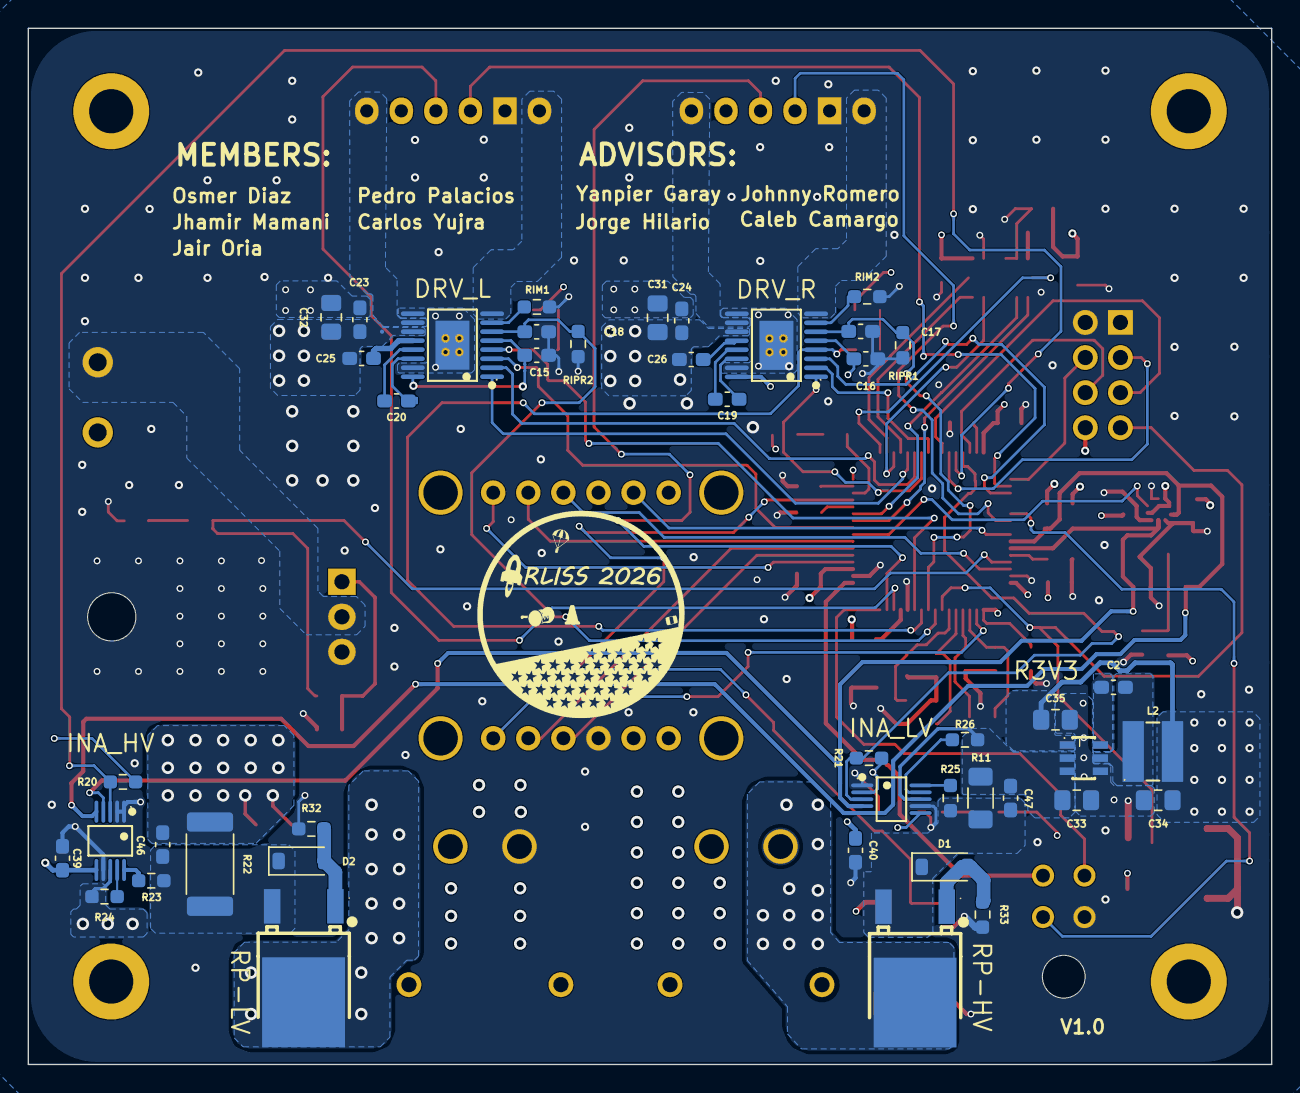
[picture p12: board ARLISS_STM32_2026.kicad_pcb from below]

Board: 4 copper layers, 90.0 x 75.0 mm, 119 parts (44 on the bottom side), 93 nets.

Other parts of the board:
TP4#2: TestPoint; TestPoint_Pad_D1.5mm

Their connections:
GND: TP4#2.1 (1_1); also elsewhere on the board
