JosephPalacios-so/CANSAT_ARLISS/(commit log)

2026-05-18 First version - ARLISS STM32 2026
    [ARLISS_STM32_2026.kicad_pcb, ARLISS_STM32_2026.kicad_sch]
2026-05-23 Mejoras hasta sábado
    [POWER.kicad_sch]
2026-05-23 STM32 mapeo
    [ARLISS_STM32_2026.kicad_pcb, DriverDRV8874.kicad_sch, EsquemáticoSTM32F405.kicad_sch, untitled.kicad_sch]
2026-05-23 Avances antes de merge
2026-05-25 STM32 actualización 25/03
    [EsquemáticoSTM32F405.kicad_sch]
2026-05-26 AVANCE STM32
    [EsquemáticoSTM32F405.kicad_sch]
2026-05-28 Protocolos I2C/SPI
    [ADXL375.kicad_sch, ARLISS_STM32_2026.kicad_sch, Barómetro DPS310.kicad_sch, EsquemáticoSTM32F405.kicad_sch, IMU.kicad_sch, INA226_sensor_sch.kicad_sch, NICROM.kicad_sch, SensorLuz_VEML7700.kicad_sch]
2026-05-28 INA SENSOR
    [ADXL375.kicad_sch, EsquemáticoSTM32F405.kicad_sch, INA226_sensor_sch.kicad_sch]
2026-05-29 Todo menos alimentación
    [DriverDRV8874.kicad_sch, NICROM.kicad_sch, SensorLuz_VEML7700.kicad_sch]
2026-05-30 ALIMENTACIÓN
    [EsquemáticoSTM32F405.kicad_sch, SensorLuz_VEML7700.kicad_sch, untitled.kicad_sch]
2026-06-01 Esquemático V1
    [ARLISS_STM32_2026.kicad_pcb, DriverDRV8874.kicad_sch, EsquemáticoSTM32F405.kicad_sch, INA226_sensor_sch.kicad_sch, NICROM.kicad_sch, untitled.kicad_sch]
2026-06-06 AVANCE 06
    [ARLISS_STM32_2026.kicad_pcb, untitled.kicad_sch]
2026-06-07 Test 00 final
    [EsquemáticoSTM32F405.kicad_sch]
2026-06-07 Parte 01 07/06
    [ARLISS_STM32_2026.kicad_pcb, Barómetro DPS310.kicad_sch, DriverDRV8874.kicad_sch, untitled.kicad_sch]
2026-06-07 feat: [solución de rules checker]
    [ADXL375.kicad_sch, ARLISS_STM32_2026.kicad_pcb, ARLISS_STM32_2026.kicad_sch, Barómetro DPS310.kicad_sch, DriverDRV8874.kicad_sch, EsquemáticoSTM32F405.kicad_sch, IMU.kicad_sch, INA226_sensor_sch.kicad_sch]
2026-06-09 Errores del esquematico solucionados
    [Barómetro DPS310.kicad_sch, DriverDRV8874.kicad_sch, EsquemáticoSTM32F405.kicad_sch, IMU.kicad_sch, untitled.kicad_sch]
2026-06-09 FOOTPRINTS V1
2026-06-09 Footprints V2
2026-06-09 Actualizacion previo al ingreso de la rama ARLISS
2026-06-14 Actualización de nets
    [ARLISS_STM32_2026.kicad_sch, DriverDRV8874.kicad_sch, EsquemáticoSTM32F405.kicad_sch, IMU.kicad_sch, SensorLuz_VEML7700.kicad_sch]
2026-06-14 Cantidad de errores en la PCB: 29
    [ADXL375.kicad_sch, ARLISS_STM32_2026.kicad_sch, Barómetro DPS310.kicad_sch, DriverDRV8874.kicad_sch, EsquemáticoSTM32F405.kicad_sch, INA226_sensor_sch.kicad_sch, SensorLuz_VEML7700.kicad_sch, untitled.kicad_sch]
2026-06-14 Cantidad de errores de la placa: 05
    [ADXL375.kicad_sch, Barómetro DPS310.kicad_sch, DriverDRV8874.kicad_sch, EsquemáticoSTM32F405.kicad_sch, INA226_sensor_sch.kicad_sch, NICROM.kicad_sch, SensorLuz_VEML7700.kicad_sch, untitled.kicad_sch]
2026-06-14 Cantidad de errores en la placa: 04
    [ARLISS_STM32_2026.kicad_pcb, Barómetro DPS310.kicad_sch, DriverDRV8874.kicad_sch, IMU.kicad_sch, NICROM.kicad_sch, SensorLuz_VEML7700.kicad_sch]
2026-06-14 Esquemático Versión mejorada
    [ARLISS_STM32_2026.kicad_sch, DriverDRV8874.kicad_sch, EsquemáticoSTM32F405.kicad_sch, SensorLuz_VEML7700.kicad_sch]
2026-06-15 PCB ordenada V1
    [ADXL375.kicad_sch, ARLISS_STM32_2026.kicad_pcb, ARLISS_STM32_2026.kicad_sch, Barómetro DPS310.kicad_sch, DriverDRV8874.kicad_sch, EsquemáticoSTM32F405.kicad_sch, IMU.kicad_sch, INA226_sensor_sch.kicad_sch]
2026-06-17 DPS ORDENADO
    [ARLISS_STM32_2026.kicad_pcb]
2026-06-18 Driver Ordenado
    [ARLISS_STM32_2026.kicad_pcb]
2026-06-20 Primer Ruteo de PCB
    [ADXL375.kicad_sch, ARLISS_STM32_2026.kicad_pcb, Barómetro DPS310.kicad_sch, DriverDRV8874.kicad_sch, EsquemáticoSTM32F405.kicad_sch, INA226_sensor_sch.kicad_sch, NICROM.kicad_sch, SensorLuz_VEML7700.kicad_sch]
2026-06-21 Arreglos de esquemático
    [ADXL375.kicad_sch, ARLISS_STM32_2026.kicad_pcb, ARLISS_STM32_2026.kicad_sch, Barómetro DPS310.kicad_sch, DriverDRV8874.kicad_sch, EsquemáticoSTM32F405.kicad_sch, INA226_sensor_sch.kicad_sch, NICROM.kicad_sch]
2026-06-22 Arreglando footprints
    [ADXL375.kicad_sch, ARLISS_STM32_2026.kicad_pcb, ARLISS_STM32_2026.kicad_sch, Barómetro DPS310.kicad_sch, DriverDRV8874.kicad_sch, EsquemáticoSTM32F405.kicad_sch, IMU.kicad_sch, INA226_sensor_sch.kicad_sch]
2026-06-23 all before traces
2026-06-25 Todo antes de PCB
    [ADXL375.kicad_sch, ARLISS_STM32_2026.kicad_pcb, EsquemáticoSTM32F405.kicad_sch, IMU.kicad_sch, INA226_sensor_sch.kicad_sch, POWER_V.kicad_sch]
2026-07-03 C14 y C1,C2,... modificados
    [ADXL375.kicad_sch, ARLISS_STM32_2026.kicad_pcb, ARLISS_STM32_2026.kicad_sch, Barómetro DPS310.kicad_sch, DriverDRV8874.kicad_sch, EsquemáticoSTM32F405.kicad_sch, IMU.kicad_sch, INA226_sensor_sch.kicad_sch]
2026-07-04 PCB Solucionado
    [ADXL375.kicad_sch, Barómetro DPS310.kicad_sch, DriverDRV8874.kicad_sch, EsquemáticoSTM32F405.kicad_sch, INA226_sensor_sch.kicad_sch, SensorLuz_VEML7700.kicad_sch]
2026-08-01 changes in schematic
2026-08-02 Avance 02/08
    [ADXL375.kicad_sch, ARLISS_STM32_2026.csv, ARLISS_STM32_2026.kicad_pcb, ARLISS_STM32_2026.kicad_sch, Barómetro Botch SMD.kicad_sch, Barómetro DPS310.kicad_sch, DriverDRV8874.kicad_sch, EsquemáticoSTM32F405.kicad_sch]
2026-08-04 FINAL SCHEMATIC
    [ADXL375.kicad_sch, Barómetro Botch SMD.kicad_sch, DriverDRV8874.kicad_sch, EsquemáticoSTM32F405.kicad_sch, NICROM.kicad_sch, POWER_V.kicad_sch, SensorLuz_VEML7700.kicad_sch]
2026-08-04 correcciones claude
    [ADXL375.kicad_sch, DriverDRV8874.kicad_sch, EsquemáticoSTM32F405.kicad_sch, INA226_sensor_sch.kicad_sch, POWER_V.kicad_sch]
2026-08-04 INA226 SOLUCIONADO
    [ARLISS_STM32_2026.kicad_pcb, INA226_sensor_sch.kicad_sch]
2026-08-10 SCHEMATICO TOTAL
    [ADXL375.kicad_sch, Barómetro Botch SMD.kicad_sch, DriverDRV8874.kicad_sch, EsquemáticoSTM32F405.kicad_sch, INA226_sensor_sch.kicad_sch, NICROM.kicad_sch, POWER_V.kicad_sch, SensorLuz_VEML7700.kicad_sch]
2026-08-10 Cambios finales antes de main
    [ARLISS_STM32_2026.kicad_pcb, POWER_V.kicad_sch]
2026-08-12 pcb order
    [ARLISS_STM32_2026.kicad_pcb, ARLISS_STM32_2026.kicad_sch]
2026-08-14 3D MODEL
    [ARLISS_STM32_2026.kicad_pcb, Alimentacion_V2.kicad_sch, NICROM.kicad_sch]
2026-08-22 FINAL PCB
    [ARLISS_STM32_2026.kicad_pcb]
2026-08-24 PLACA FINISHED
    [ADXL375.kicad_sch, ARLISS_STM32_2026.csv, ARLISS_STM32_2026.kicad_pcb, INA226_sensor_sch.kicad_sch, NICROM.kicad_sch]
2026-08-25 VERSION FINAL
    [ARLISS_STM32_2026.csv, ARLISS_STM32_2026.kicad_pcb, Alimentacion_V2.kicad_sch, NICROM.kicad_sch, POWER_V.kicad_sch]
2026-08-25 VERSION FINAL - ARLISS STM32 2026
